will-hut/Prototypical/Script/Gamma_Color_Test/granger.png

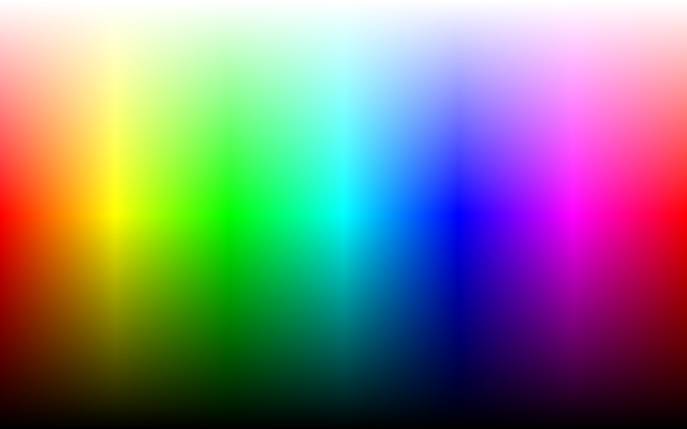
Script/Gamma_Color_Test/granger.png
