will-hut/Prototypical/Script/Img_to_Buffer/image.jpg

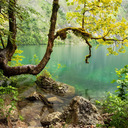
Script/Img_to_Buffer/image.jpg
