will-hut/Prototypical/Script/Img_to_Buffer/image3.jpg

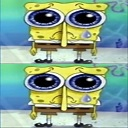
Script/Img_to_Buffer/image3.jpg
