will-hut/Prototypical/HW/HUB75-FPGA-Card/HUB75-FPGA-Card.xlsx

Item | Qty | Reference(s) | Name | Placed By | Digikey Link
1 | 32 | C1, C5, C6, C7, C8, C9, C12, C14, C15, C16, C17, C18, C20, C21, C22, C25, C26, C27, C30, C31, C32, C33, C34, C35, C36, C38, C41, C44, C45, C46, C53, C54 | 100n Cap 0603 | JLC
2 | 5 | C2, C13, C37, C39, C40 | 4.7u Cap 0603 | JLC
3 | 9 | C3, C28, C29, C42, C43, C48, C49, C52, C55 | 10u Cap 0603 | JLC
4 | 8 | C4, C10, C11, C23, C24, C47, C50, C51 | 1u Cap 0603 | JLC
5 | 1 | D1 | LED Red 0603 | JLC
6 | 5 | FB1, FB2, FB3, FB4, FB5 | FerriteBead 0603 | JLC
7 | 4 | H1, H2, H3, H4 | MountingHole | N/A
8 | 1 | J1 | JTAG 2x4 2.54mm | Me | Standard Pin headers
9 | 4 | J2, J4, J5, J7 | LedStrip 1x3 2.54mm | Me | Standard Pin headers
10 | 2 | J3, J6 | Hub75 IDC 16pin | Me | https://www.digikey.com/en/products/detail/cnc-tech/3020-16-0100-00/3441733
11 | 1 | J8 | Speaker 5.00mm 4 Screw Terminal | Me | https://www.digikey.com/en/products/detail/cui-devices/TB002-500-04BE/10064071
12 | 1 | J9 | USB_C_Receptacle_USB2.0 | Me | https://www.digikey.com/en/products/detail/gct/USB4105-GF-A/11198441
13 | 1 | J10 | USB_A_Stacked | Me | https://www.digikey.com/en/products/detail/cui-devices/UJ2-ADH-1-TH/6187916
14 | 2 | J11, J12 | Wirepad | N/A
15 | 4 | J13, J14, J15, J16 | Wirepad | N/A
16 | 16 | R1, R2, R3, R4, R5, R6, R7, R8, R9, R10, R11, R12, R13, R14, R15, R19 | 10k | JLC
17 | 1 | R16 | 12k | JLC
18 | 1 | R17 | 2.2k | JLC
19 | 1 | R18 | 470R | JLC
20 | 2 | R20, R21 | 5.1k | JLC
21 | 1 | U1 | T20Q100F3 | Me | https://www.digikey.com/en/products/detail/efinix-inc/T20Q100F3C3/19100262
22 | 1 | U2 | XC6206PxxxMR | JLC
23 | 1 | U3 | AP2112K-1.2 | Me | https://www.digikey.com/en/products/detail/diodes-incorporated/AP2112K-1-2TRG1/4570636
24 | 1 | U4 | 74AHCT245PW | Me | https://www.digikey.com/en/products/detail/nexperia-usa-inc/74AHCT245PW-118/1229680
25 | 1 | U5 | 74AHCT245PW | Me | https://www.digikey.com/en/products/detail/nexperia-usa-inc/74AHCT245PW-118/1229680
26 | 1 | U6 | 74AHCT245PW | Me | https://www.digikey.com/en/products/detail/nexperia-usa-inc/74AHCT245PW-118/1229680
27 | 1 | U7 | FT232H | Me | https://www.digikey.com/en/products/detail/ftdi-future-technology-devices-international-ltd/FT232HL-REEL/2614627
28 | 1 | U8 | 93LCxxBxxOT | Me | https://www.digikey.com/en/products/detail/microchip-technology/93LC56BT-I-OT/572825
29 | 1 | U9 | WMM7037AT2 | JLC
30 | 1 | U10 | HS-100B | JLC
31 | 1 | U11 | PAM8406 | JLC
32 | 1 | U12 | USBLC6-2SC6 | Me | https://www.digikey.com/en/products/detail/stmicroelectronics/USBLC6-2SC6/1040559
33 | 1 | U13 | CH334R | JLC
34 | 1 | X1 | ECS-2520MV-xxx-xx | Me | https://www.digikey.com/en/products/detail/ecs-inc/ECS-2520MV-250-CN-TR/8593608
35 | 1 | Y1 | Crystal_GND24 | JLC
