will-hut/Prototypical/HW/HUB75-FPGA-Card/3dmodels/AMM-3742-T-R--3DModel-STEP-461651.STEP

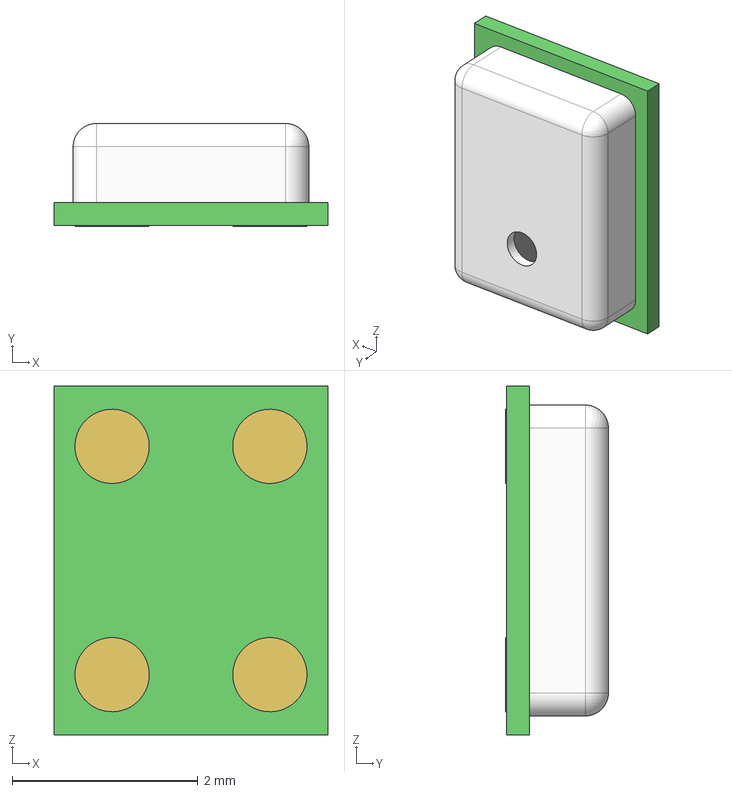
[picture p4: CAD file, 2024-02-10]
HW/HUB75-FPGA-Card/3dmodels/AMM-3742-T-R--3DModel-STEP-461651.STEP
2.95 x 1.11 x 3.76 mm
