will-hut/Prototypical/HW/HUB75-FPGA-Card/3dmodels/SS-52100-002--3DModel-STEP-510211.STEP

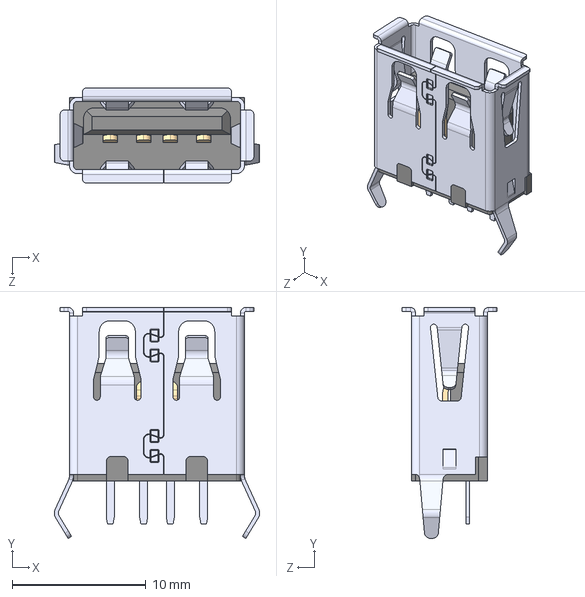
[picture p5: CAD file, 2024-02-10]
HW/HUB75-FPGA-Card/3dmodels/SS-52100-002--3DModel-STEP-510211.STEP
15.4 x 17.3 x 7.12 mm
