will-hut/Prototypical/HW/HUB75-FPGA-Card/3dmodels/TS-1187A-B-A-B.step

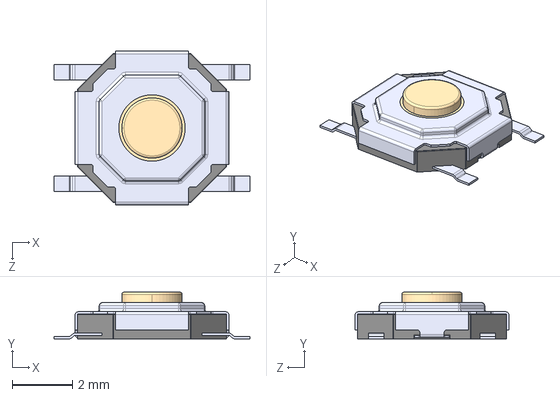
[picture p6: CAD file, 2024-02-10]
HW/HUB75-FPGA-Card/3dmodels/TS-1187A-B-A-B.step
6.50 x 1.55 x 5.10 mm
