will-hut/Prototypical/HW/HUB75-FPGA-Card/3dmodels/USB4145-03-0170-C_REVA2.step

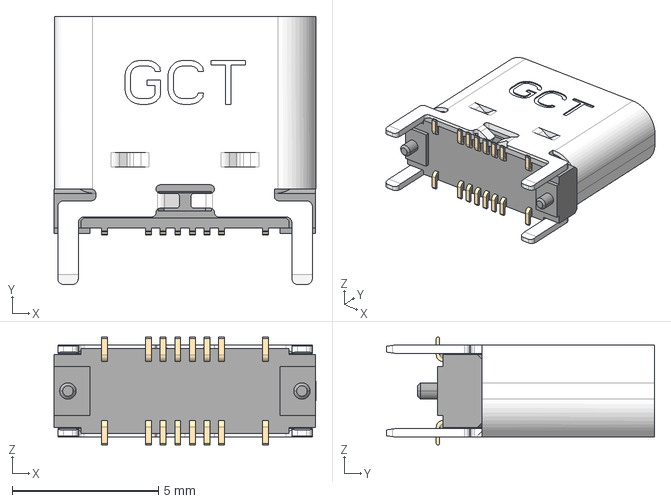
[picture p7: CAD file, 2024-02-08]
HW/HUB75-FPGA-Card/3dmodels/USB4145-03-0170-C_REVA2.step
8.95 x 9.16 x 3.69 mm
