will-hut/Prototypical/HW/Power-Module/Power-Module.kicad_pcb

## KiCad design HW/Power-Module/Power-Module.kicad_pcb (2024-02-26)

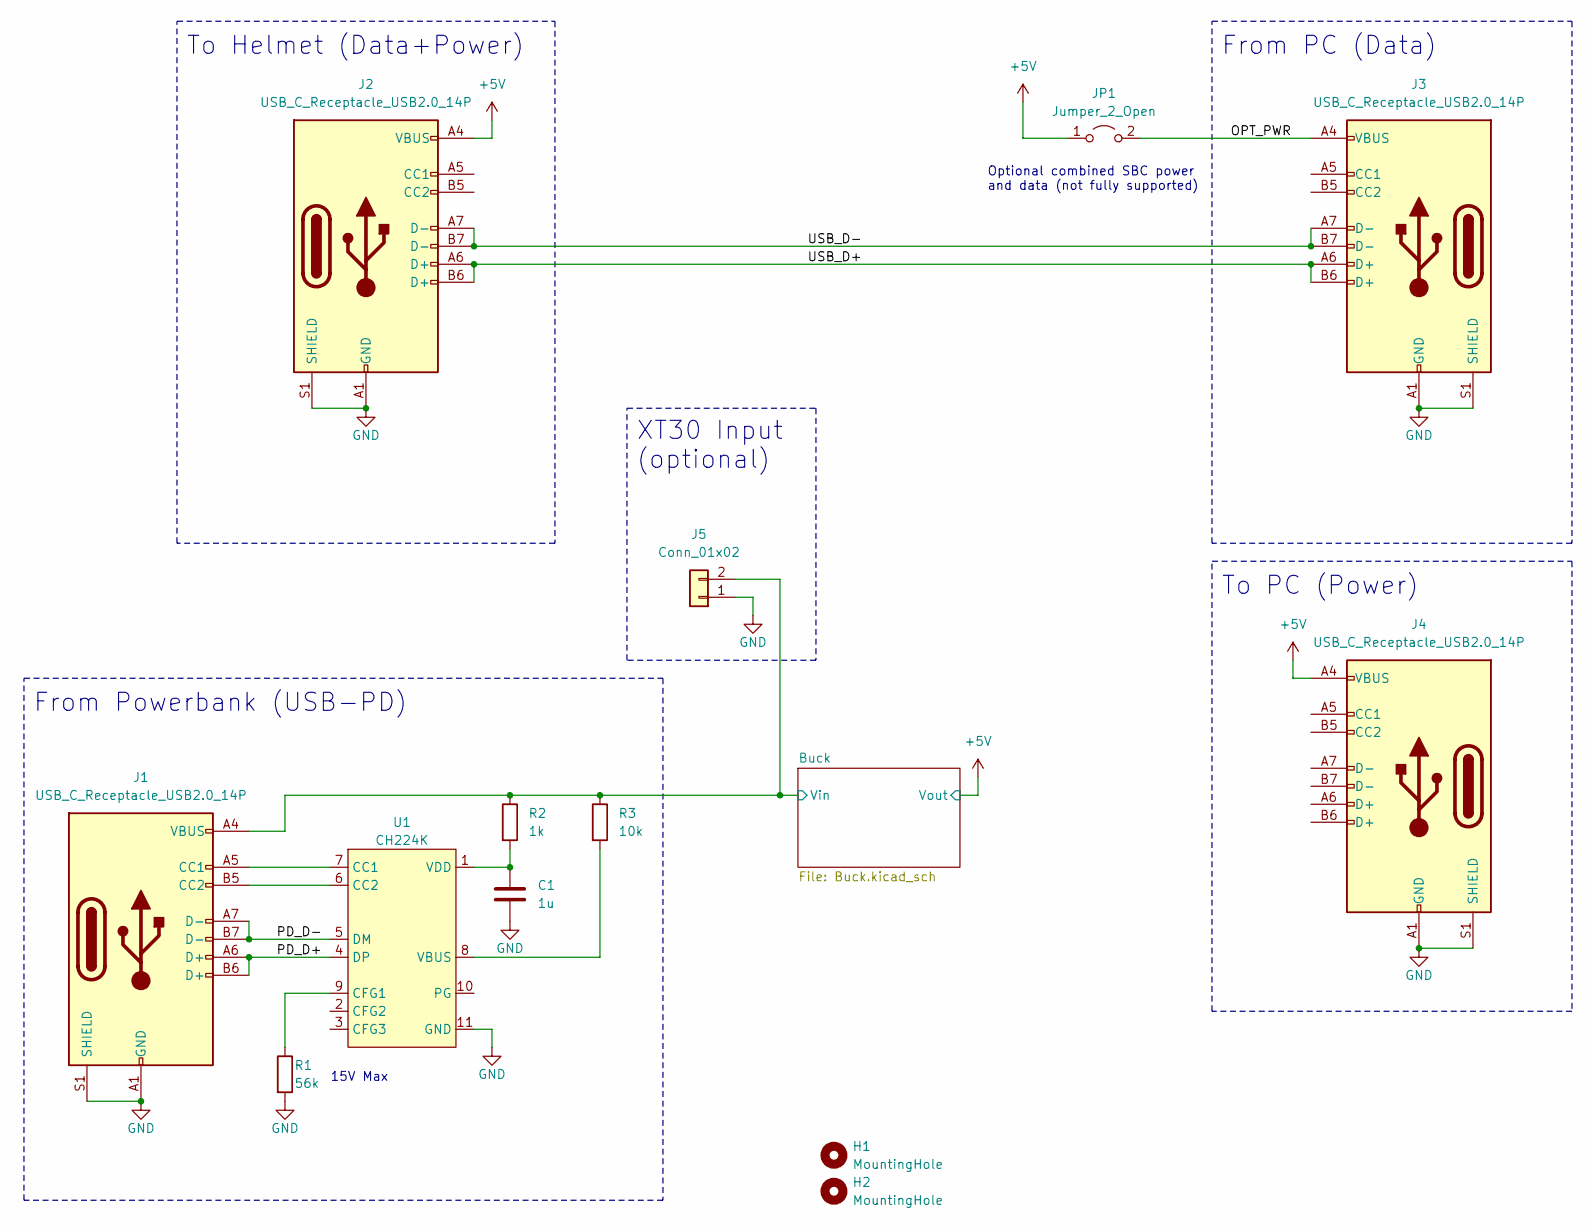
[picture p8: schematic Power-Module.kicad_sch]

Parts:
C1: 1u; C_0603_1608Metric; LCSC C15849
H1, H2: MountingHole; MountingHole_3.2mm_M3
J1, J2, J3, J4: USB_C_Receptacle_USB2.0_14P; USB_C_Receptacle_GCT_USB4105-xx-A_16P_TopMnt_Horizontal
J5: Conn_01x02; AMASS_XT30U-F_1x02_P5.0mm_Vertical
JP1: Jumper_2_Open; SolderJumper-2_P1.3mm_Open_Pad1.0x1.5mm
R1: 56k; R_0603_1608Metric; LCSC C23206
R2: 1k; R_0603_1608Metric; LCSC C21190
R3: 10k; R_0603_1608Metric; LCSC C25804
U1: CH224K; ESSOP-10_L4.9-W3.9-P1.0-LS6.0-TL-EP; LCSC Part C970725

Connections:
+5V: J2.A4 (VBUS), J2.A9 (VBUS), J2.B4 (VBUS), J2.B9 (VBUS), J4.A4 (VBUS), J4.A9 (VBUS), J4.B4 (VBUS), J4.B9 (VBUS), JP1.1 (A); also elsewhere on the board
/Buck/Vin: J1.A4 (VBUS), J1.A9 (VBUS), J1.B4 (VBUS), J1.B9 (VBUS), J5.2, R2.1, R3.1; also elsewhere on the board
/OPT_PWR: J3.A4 (VBUS), J3.A9 (VBUS), J3.B4 (VBUS), J3.B9 (VBUS), JP1.2 (B)
/PD_D+: J1.A6 (D+), J1.B6 (D+), U1.4 (DP)
/PD_D-: J1.A7 (D-), J1.B7 (D-), U1.5 (DM)
/USB_D+: J2.A6 (D+), J2.B6 (D+), J3.A6 (D+), J3.B6 (D+)
/USB_D-: J2.A7 (D-), J2.B7 (D-), J3.A7 (D-), J3.B7 (D-)
GND: C1.2, J1.A1 (GND), J1.A12 (GND), J1.B1 (GND), J1.B12 (GND), J1.S1 (SHIELD), J2.A1 (GND), J2.A12 (GND), J2.B1 (GND), J2.B12 (GND), J2.S1 (SHIELD), J3.A1 (GND), J3.A12 (GND), J3.B1 (GND), J3.B12 (GND), J3.S1 (SHIELD), J4.A1 (GND), J4.A12 (GND), J4.B1 (GND), J4.B12 (GND), J4.S1 (SHIELD), J5.1, R1.2, U1.11 (GND); also elsewhere on the board
unnamed: J1.A5 (CC1), U1.7 (CC1)
unnamed: J1.B5 (CC2), U1.6 (CC2)
unnamed: R1.1, U1.9 (CFG1)
unnamed: R3.2, U1.8 (VBUS)
unnamed: C1.1, R2.2, U1.1 (VDD)

Notes on the sheet:
To Helmet (Data+Power)
From PC (Data)
Optional combined SBC power and data (not fully supported)
15V Max
From Powerbank (USB-PD)
To PC (Power)
XT30 Input (optional)

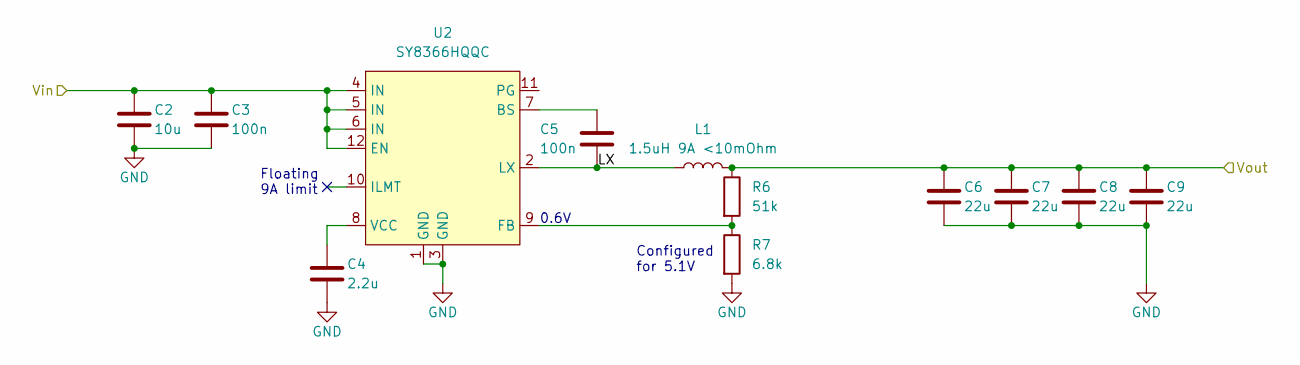
[picture p9: schematic Buck.kicad_sch]

Parts:
C2: 10u; C_0603_1608Metric
C3, C5: 100n; C_0603_1608Metric
C4: 2.2u; C_0603_1608Metric
C6, C7, C8, C9: 22u; C_0805_2012Metric
L1: 1.5uH 9A <10mOhm; IND-SMD_L7.0-W6.6
R6: 51k; R_0603_1608Metric
R7: 6.8k; R_0603_1608Metric
U2: SY8366HQQC; QFN-12_L3.0-W3.0-P0.45-TL-EP; LCSC Part C178253

Connections:
+5V: C6.1, C7.1, C8.1, C9.1, L1.2, R6.1; also elsewhere on the board
/Buck/LX: C5.2, L1.1, U2.2 (LX)
/Buck/Vin: C2.1, C3.1, U2.4 (IN), U2.5 (IN), U2.6 (IN), U2.12 (EN); also elsewhere on the board
GND: C2.2, C3.2, C4.2, C6.2, C7.2, C8.2, C9.2, R7.2, U2.1 (GND), U2.3 (GND); also elsewhere on the board
unnamed: C5.1, U2.7 (BS)
unnamed: R6.2, R7.1, U2.9 (FB)
unnamed: C4.1, U2.8 (VCC)

Notes on the sheet:
Floating 9A limit
0.6V
Configured for 5.1V

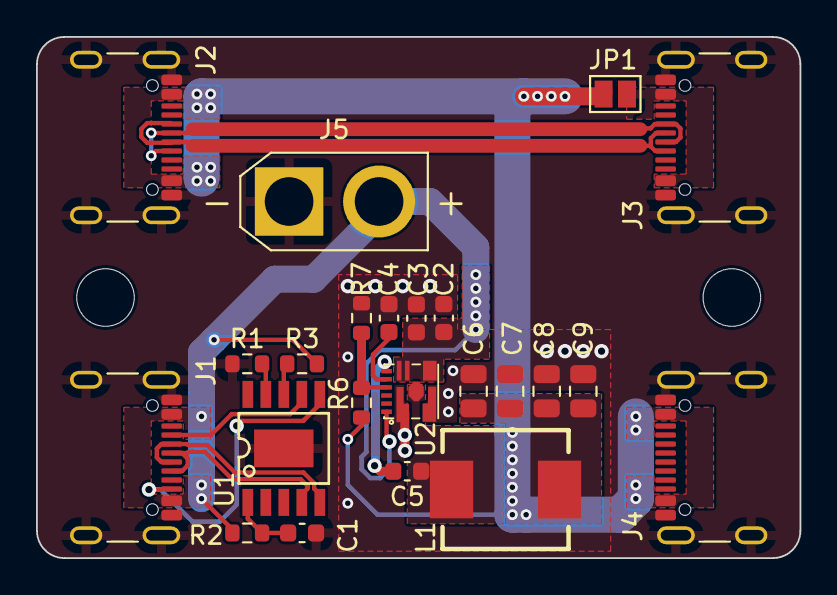
[picture p10: board Power-Module.kicad_pcb from above]

Board: 2 copper layers, 42.4 x 29.0 mm, 25 parts (0 on the bottom side), 17 nets.
