will-hut/Prototypical/HW/HUB75-FPGA-Card/HUB75-FPGA-Card.kicad_pcb

## KiCad design HW/HUB75-FPGA-Card/HUB75-FPGA-Card.kicad_pcb (2024-02-26)

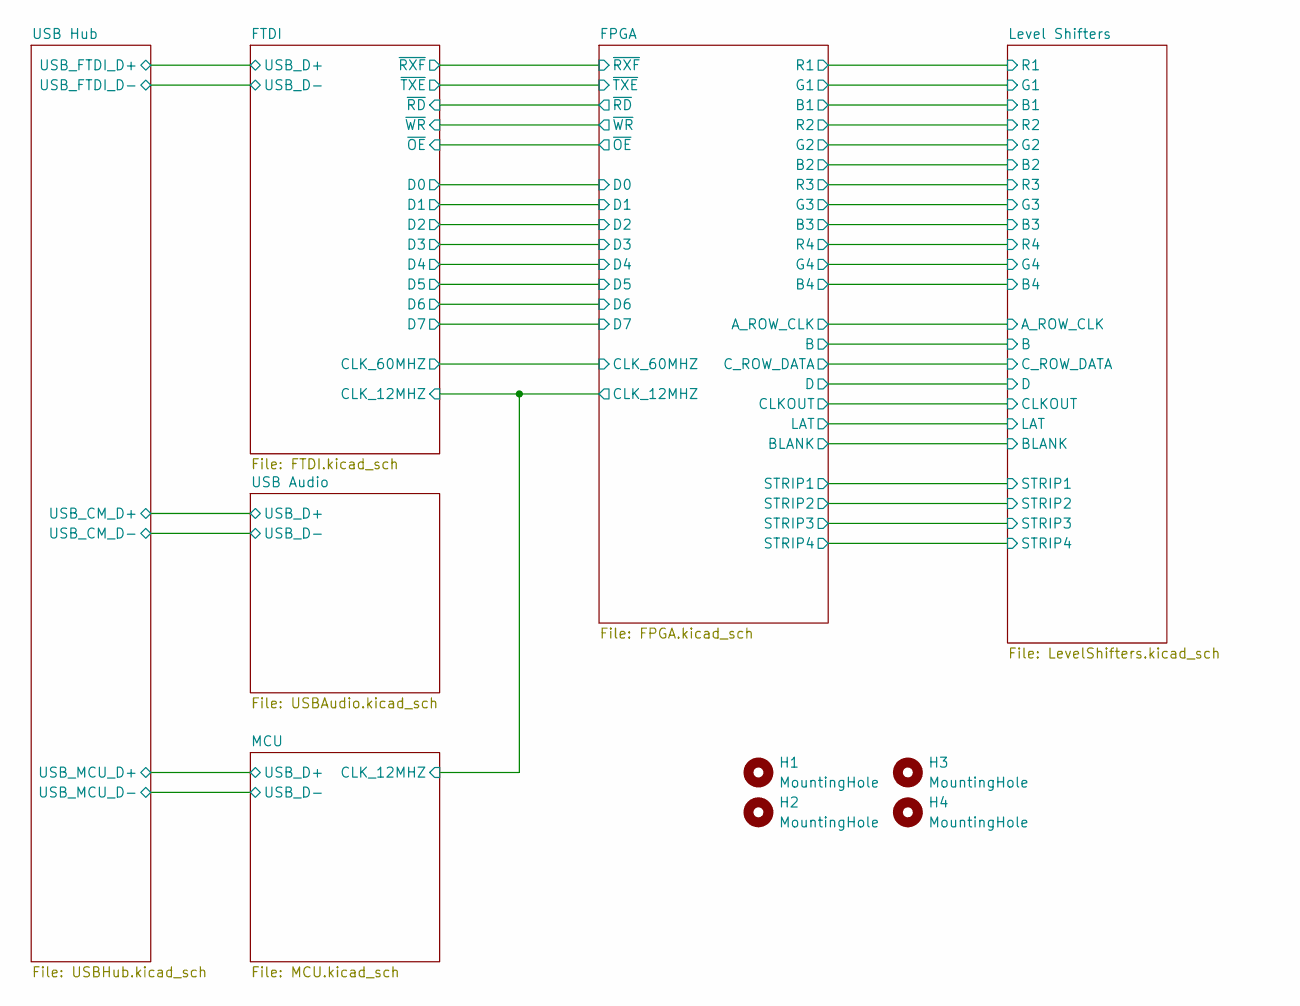
[picture p11: schematic HUB75-FPGA-Card.kicad_sch]

Parts:
H1, H2, H3, H4: MountingHole; MountingHole_3.2mm_M3

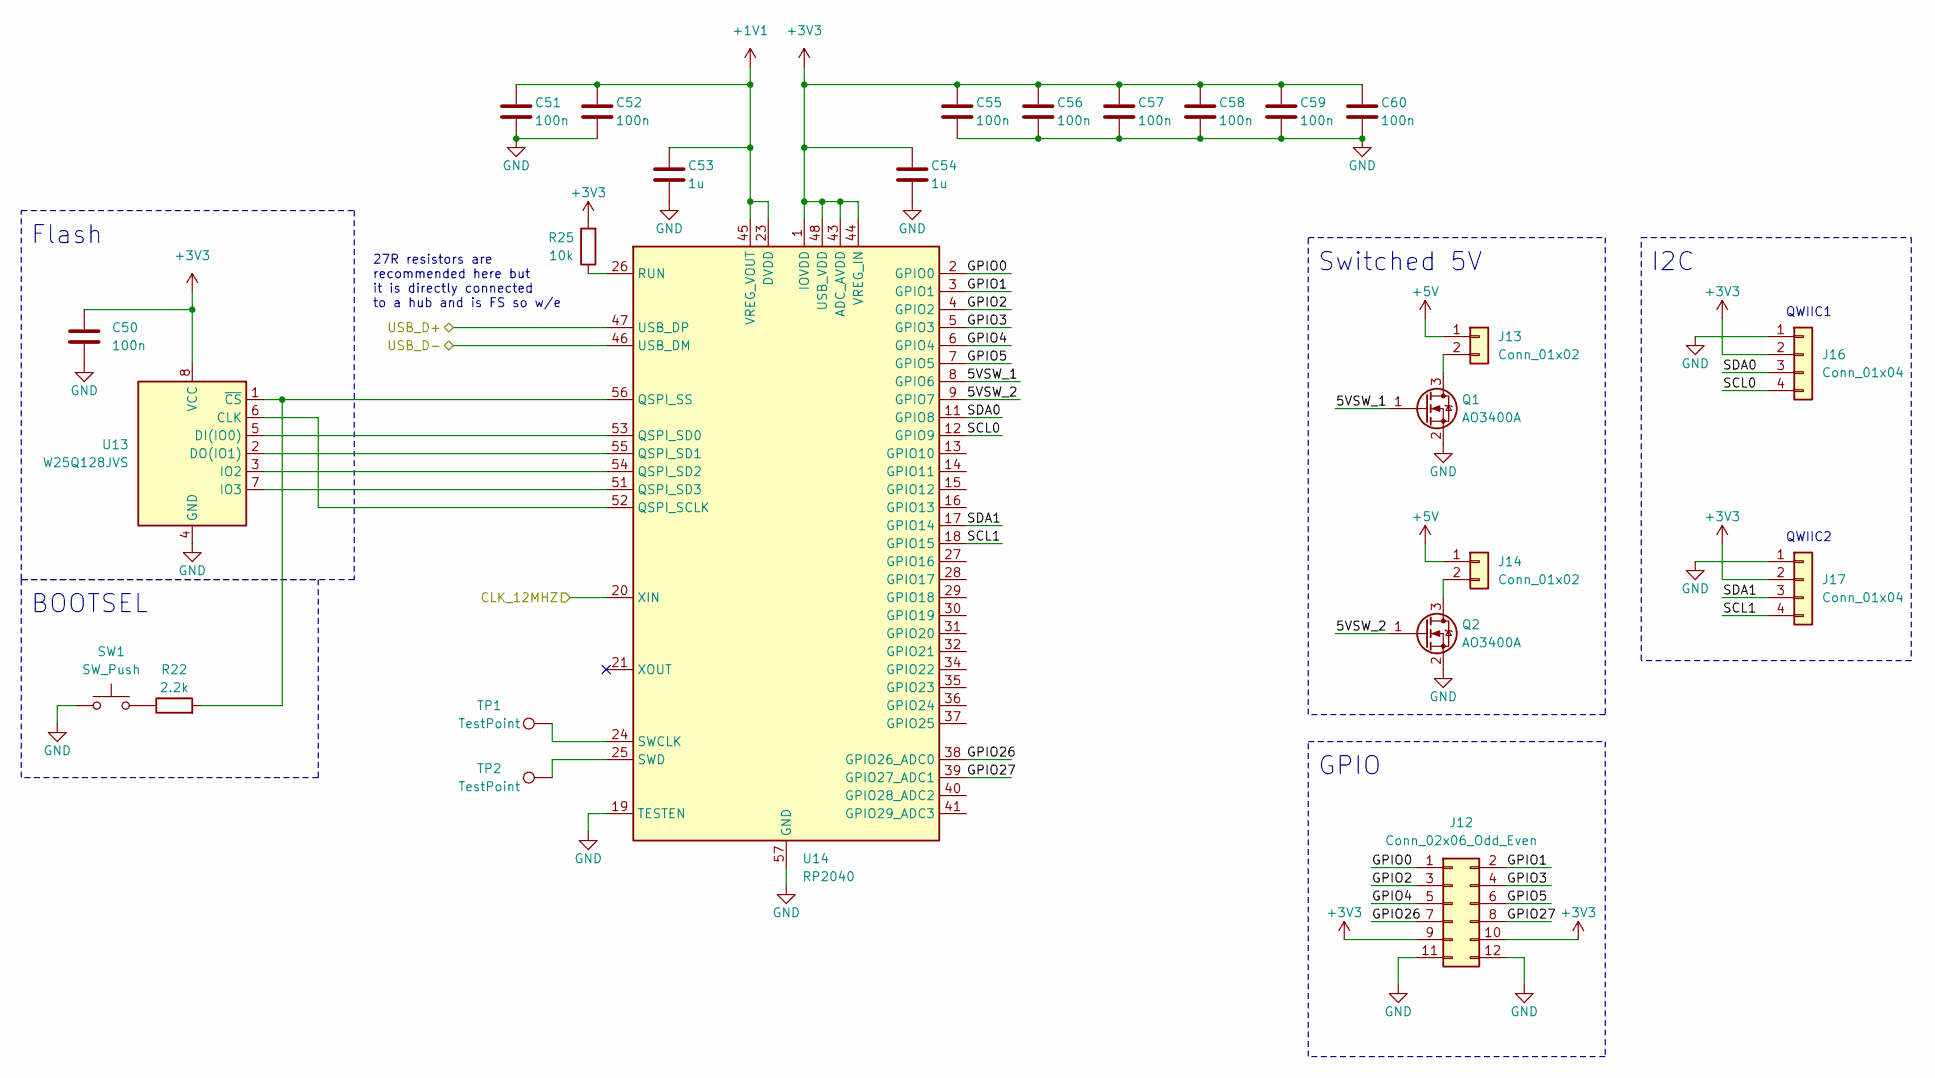
[picture p12: schematic MCU.kicad_sch]

Parts:
C50, C51, C52, C55, C56, C57, C58, C59, C60: 100n; C_0603_1608Metric
C53, C54: 1u; C_0603_1608Metric
J12: Conn_02x06_Odd_Even; PinHeader_2x06_P2.54mm_Vertical
J13, J14: Conn_01x02; PinHeader_1x02_P2.54mm_Vertical
J16, J17: Conn_01x04; JST_SH_BM04B-SRSS-TB_1x04-1MP_P1.00mm_Vertical
Q1, Q2: AO3400A; SOT-23
R22: 2.2k; R_0603_1608Metric
R25: 10k; R_0603_1608Metric
SW1: SW_Push; SW_TS-1187A-B-A-B
TP1, TP2: TestPoint; TestPoint_Pad_D1.0mm
U13: W25Q128JVS; SOIC-8_5.23x5.23mm_P1.27mm
U14: RP2040; QFN-56-1EP_7x7mm_P0.4mm_EP3.2x3.2mm

Connections:
+1V1: C51.1, C52.1, C53.1, U14.23 (DVDD), U14.45 (VREG_VOUT), U14.50 (DVDD)
+3V3: C50.1, C54.1, C55.1, C56.1, C57.1, C58.1, C59.1, C60.1, J12.9, J12.10, J16.2, J17.2, R25.2, U13.8 (VCC), U14.1 (IOVDD), U14.10 (IOVDD), U14.22 (IOVDD), U14.33 (IOVDD), U14.42 (IOVDD), U14.43 (ADC_AVDD), U14.44 (VREG_IN), U14.48 (USB_VDD), U14.49 (IOVDD); also elsewhere on the board
+5V: J13.1, J14.1; also elsewhere on the board
/FPGA/CLK_12MHZ: U14.20 (XIN); also elsewhere on the board
/MCU/5VSW_1: Q1.1 (G), U14.8 (GPIO6)
/MCU/5VSW_2: Q2.1 (G), U14.9 (GPIO7)
/MCU/GPIO0: J12.1, U14.2 (GPIO0)
/MCU/GPIO1: J12.2, U14.3 (GPIO1)
/MCU/GPIO2: J12.3, U14.4 (GPIO2)
/MCU/GPIO3: J12.4, U14.5 (GPIO3)
/MCU/GPIO4: J12.5, U14.6 (GPIO4)
/MCU/GPIO5: J12.6, U14.7 (GPIO5)
/MCU/GPIO26: J12.7, U14.38 (GPIO26_ADC0)
/MCU/GPIO27: J12.8, U14.39 (GPIO27_ADC1)
/MCU/SCL0: J16.4, U14.12 (GPIO9)
/MCU/SCL1: J17.4, U14.18 (GPIO15)
/MCU/SDA0: J16.3, U14.11 (GPIO8)
/MCU/SDA1: J17.3, U14.17 (GPIO14)
/MCU/USB_D+: U14.47 (USB_DP); also elsewhere on the board
/MCU/USB_D-: U14.46 (USB_DM); also elsewhere on the board
GND: C50.2, C51.2, C52.2, C53.2, C54.2, C55.2, C56.2, C57.2, C58.2, C59.2, C60.2, J12.11, J12.12, J16.1, J17.1, Q1.2 (S), Q2.2 (S), SW1.1, U13.4 (GND), U14.19 (TESTEN), U14.57 (GND); also elsewhere on the board
unnamed: J13.2, Q1.3 (D)
unnamed: J14.2, Q2.3 (D)
unnamed: R22.1, SW1.2
unnamed: U13.6 (CLK), U14.52 (QSPI_SCLK)
unnamed: U13.5 (DI(IO0)), U14.53 (QSPI_SD0)
unnamed: U13.2 (DO(IO1)), U14.55 (QSPI_SD1)
unnamed: U13.3 (IO2), U14.54 (QSPI_SD2)
unnamed: U13.7 (IO3), U14.51 (QSPI_SD3)
unnamed: R22.2, U13.1 (~CS), U14.56 (QSPI_SS)
unnamed: R25.1, U14.26 (RUN)
unnamed: TP1.1, U14.24 (SWCLK)
unnamed: TP2.1, U14.25 (SWD)

Notes on the sheet:
Flash
QWIIC2
27R resistors are recommended here but it is directly connected to a hub and is FS so w/e
I2C
GPIO
Switched 5V
QWIIC1
BOOTSEL

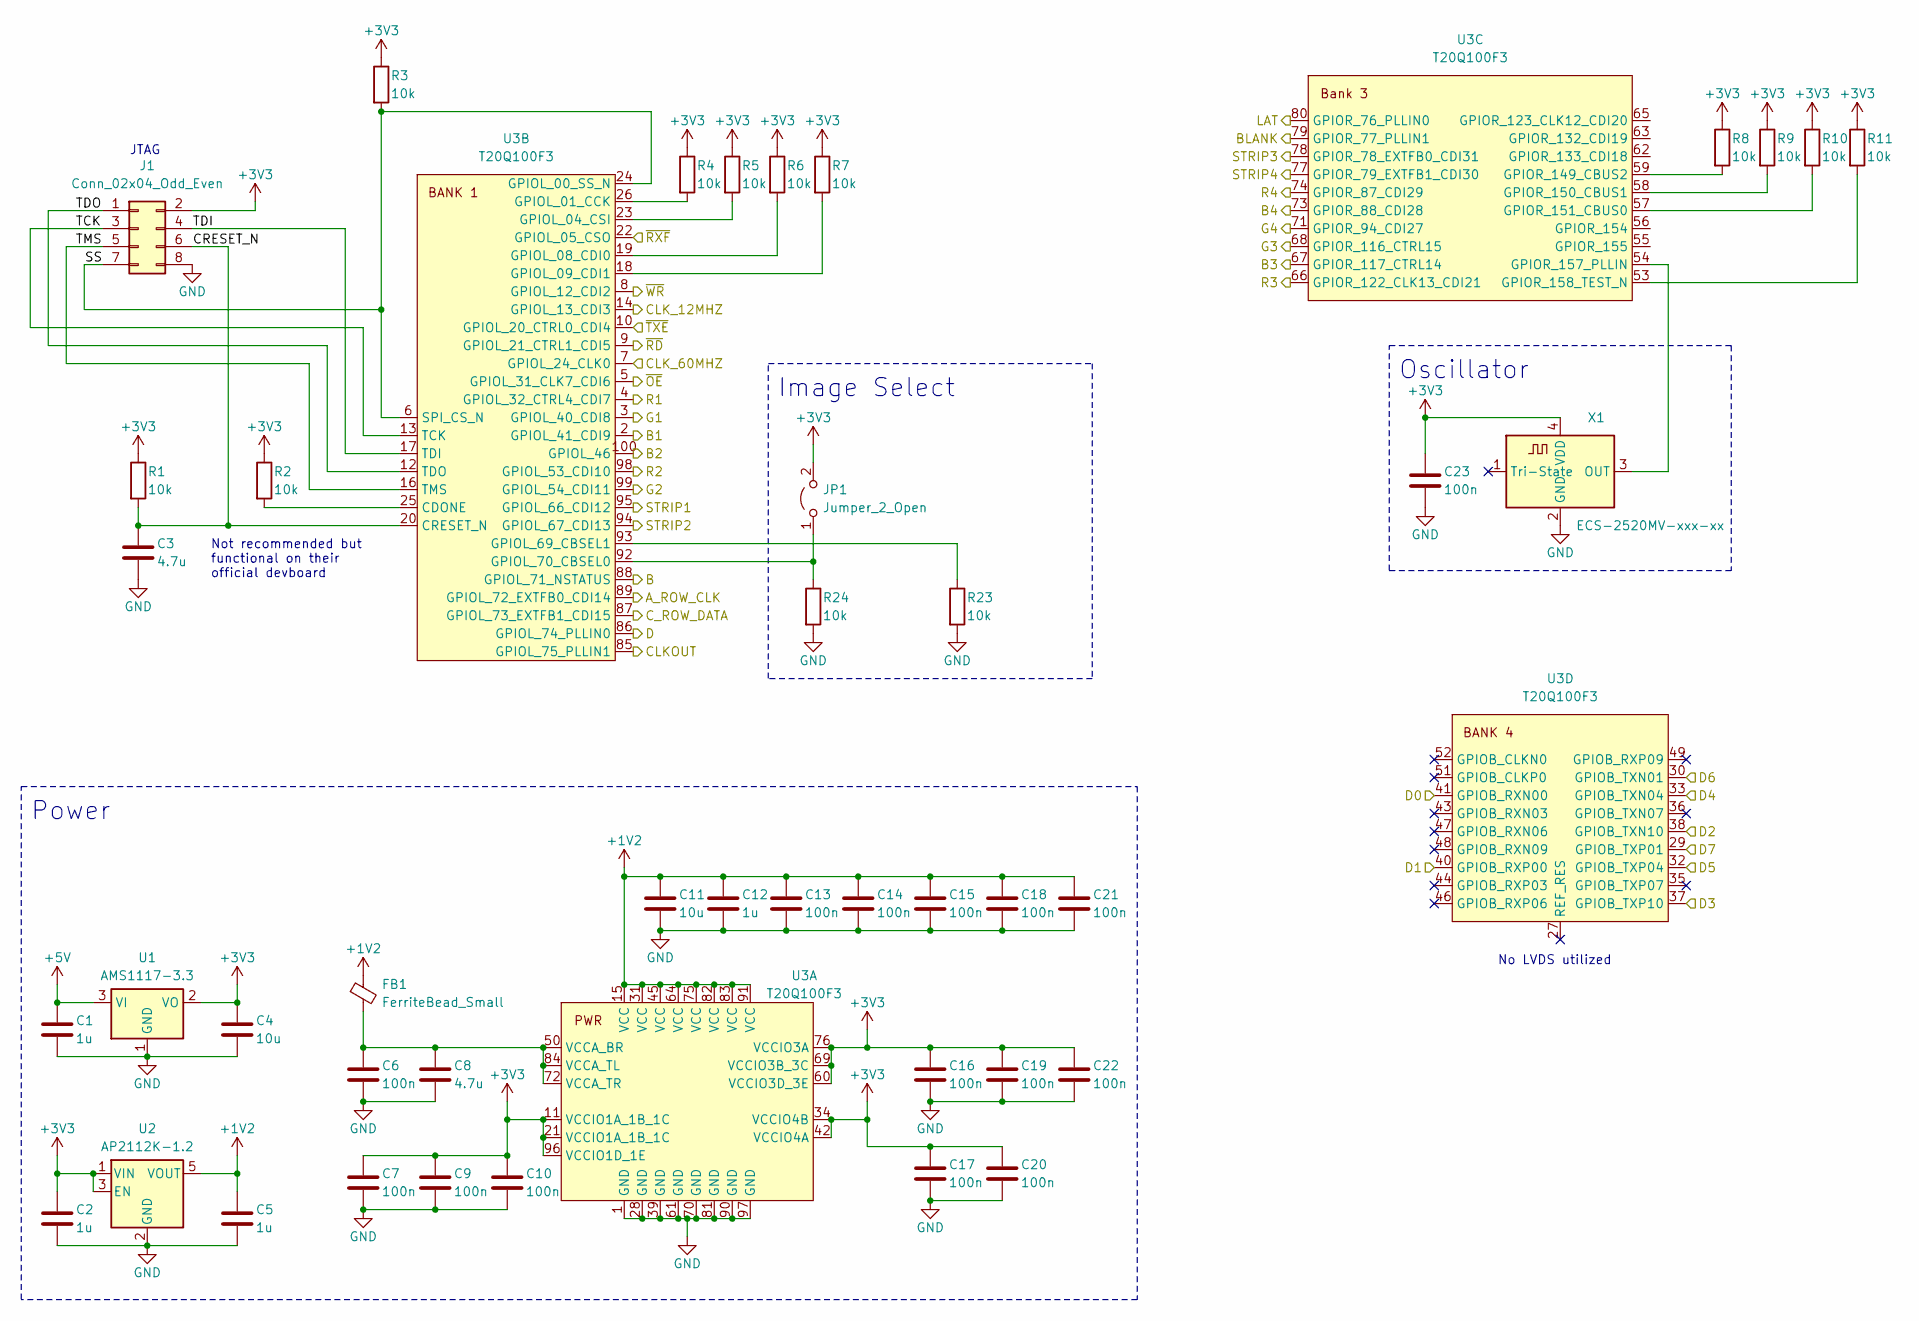
[picture p13: schematic FPGA.kicad_sch]

Parts:
C1, C2, C5, C12: 1u; C_0603_1608Metric
C3, C8: 4.7u; C_0603_1608Metric
C4, C11: 10u; C_0603_1608Metric
C6, C7, C9, C10, C13, C14, C15, C16, C17, C18, C19, C20, C21, C22, C23: 100n; C_0603_1608Metric
FB1: FerriteBead_Small; R_0603_1608Metric
J1: Conn_02x04_Odd_Even; PinHeader_2x04_P2.54mm_Vertical
JP1: Jumper_2_Open; PinHeader_1x02_P2.54mm_Vertical
R1, R2, R3, R4, R5, R6, R7, R8, R9, R10, R11, R23, R24: 10k; R_0603_1608Metric
U1: AMS1117-3.3; SOT-223-3_TabPin2
U2: AP2112K-1.2; SOT-23-5
U3: T20Q100F3; TQFP-100_14x14mm_P0.5mm
X1: ECS-2520MV-xxx-xx; Oscillator_SMD_ECS_2520MV-xxx-xx-4Pin_2.5x2.0mm

Connections:
+1V2: C5.1, C11.1, C12.1, C13.1, C14.1, C15.1, C18.1, C21.1, FB1.1, U2.5 (VOUT), U3.15 (VCC), U3.31 (VCC), U3.45 (VCC), U3.64 (VCC), U3.75 (VCC), U3.82 (VCC), U3.83 (VCC), U3.91 (VCC)
+3V3: C2.1, C4.1, C7.1, C9.1, C10.1, C16.1, C17.1, C19.1, C20.1, C22.1, C23.1, J1.2, JP1.2 (B), R1.1, R2.1, R3.1, R4.1, R5.1, R6.1, R7.1, R8.1, R9.1, R10.1, R11.1, U1.2 (VO), U2.1 (VIN), U2.3 (EN), U3.11 (VCCIO1A_1B_1C), U3.21 (VCCIO1A_1B_1C), U3.34 (VCCIO4B), U3.42 (VCCIO4A), U3.60 (VCCIO3D_3E), U3.69 (VCCIO3B_3C), U3.76 (VCCIO3A), U3.96 (VCCIO1D_1E), X1.4 (VDD); also elsewhere on the board
+5V: C1.1, U1.3 (VI); also elsewhere on the board
/FPGA/A_ROW_CLK: U3.89 (GPIOL_72_EXTFB0_CDI14); also elsewhere on the board
/FPGA/B: U3.88 (GPIOL_71_NSTATUS); also elsewhere on the board
/FPGA/B1: U3.2 (GPIOL_41_CDI9); also elsewhere on the board
/FPGA/B2: U3.100 (GPIOL_46); also elsewhere on the board
/FPGA/B3: U3.67 (GPIOR_117_CTRL14); also elsewhere on the board
/FPGA/B4: U3.73 (GPIOR_88_CDI28); also elsewhere on the board
/FPGA/BLANK: U3.79 (GPIOR_77_PLLIN1); also elsewhere on the board
/FPGA/CLKOUT: U3.85 (GPIOL_75_PLLIN1); also elsewhere on the board
/FPGA/CLK_12MHZ: U3.14 (GPIOL_13_CDI3); also elsewhere on the board
/FPGA/CLK_60MHZ: U3.7 (GPIOL_24_CLK0); also elsewhere on the board
/FPGA/CRESET_N: C3.1, J1.6, R1.2, U3.20 (CRESET_N)
/FPGA/C_ROW_DATA: U3.87 (GPIOL_73_EXTFB1_CDI15); also elsewhere on the board
/FPGA/D: U3.86 (GPIOL_74_PLLIN0); also elsewhere on the board
/FPGA/D0: U3.41 (GPIOB_RXN00); also elsewhere on the board
/FPGA/D1: U3.40 (GPIOB_RXP00); also elsewhere on the board
/FPGA/D2: U3.38 (GPIOB_TXN10); also elsewhere on the board
/FPGA/D3: U3.37 (GPIOB_TXP10); also elsewhere on the board
/FPGA/D4: U3.33 (GPIOB_TXN04); also elsewhere on the board
/FPGA/D5: U3.32 (GPIOB_TXP04); also elsewhere on the board
/FPGA/D6: U3.30 (GPIOB_TXN01); also elsewhere on the board
/FPGA/D7: U3.29 (GPIOB_TXP01); also elsewhere on the board
/FPGA/G1: U3.3 (GPIOL_40_CDI8); also elsewhere on the board
/FPGA/G2: U3.99 (GPIOL_54_CDI11); also elsewhere on the board
/FPGA/G3: U3.68 (GPIOR_116_CTRL15); also elsewhere on the board
/FPGA/G4: U3.71 (GPIOR_94_CDI27); also elsewhere on the board
/FPGA/LAT: U3.80 (GPIOR_76_PLLIN0); also elsewhere on the board
/FPGA/R1: U3.4 (GPIOL_32_CTRL4_CDI7); also elsewhere on the board
/FPGA/R2: U3.98 (GPIOL_53_CDI10); also elsewhere on the board
/FPGA/R3: U3.66 (GPIOR_122_CLK13_CDI21); also elsewhere on the board
/FPGA/R4: U3.74 (GPIOR_87_CDI29); also elsewhere on the board
/FPGA/SS: J1.7, R3.2, U3.6 (SPI_CS_N), U3.24 (GPIOL_00_SS_N)
/FPGA/STRIP1: U3.95 (GPIOL_66_CDI12); also elsewhere on the board
/FPGA/STRIP2: U3.94 (GPIOL_67_CDI13); also elsewhere on the board
/FPGA/STRIP3: U3.78 (GPIOR_78_EXTFB0_CDI31); also elsewhere on the board
/FPGA/STRIP4: U3.77 (GPIOR_79_EXTFB1_CDI30); also elsewhere on the board
/FPGA/TCK: J1.3, U3.13 (TCK)
/FPGA/TDI: J1.4, U3.17 (TDI)
/FPGA/TDO: J1.1, U3.12 (TDO)
/FPGA/TMS: J1.5, U3.16 (TMS)
/FPGA/~OE: U3.5 (GPIOL_31_CLK7_CDI6); also elsewhere on the board
/FPGA/~RD: U3.9 (GPIOL_21_CTRL1_CDI5); also elsewhere on the board
/FPGA/~RXF: U3.22 (GPIOL_05_CSO); also elsewhere on the board
/FPGA/~TXE: U3.10 (GPIOL_20_CTRL0_CDI4); also elsewhere on the board
/FPGA/~WR: U3.8 (GPIOL_12_CDI2); also elsewhere on the board
GND: C1.2, C2.2, C3.2, C4.2, C5.2, C6.2, C7.2, C8.2, C9.2, C10.2, C11.2, C12.2, C13.2, C14.2, C15.2, C16.2, C17.2, C18.2, C19.2, C20.2, C21.2, C22.2, C23.2, J1.8, R23.2, R24.2, U1.1 (GND), U2.2 (GND), U3.1 (GND), U3.28 (GND), U3.39 (GND), U3.61 (GND), U3.70 (GND), U3.81 (GND), U3.90 (GND), U3.97 (GND), X1.2 (GND); also elsewhere on the board
unnamed: JP1.1 (A), R24.1, U3.92 (GPIOL_70_CBSEL0)
unnamed: C6.1, C8.1, FB1.2, U3.50 (VCCA_BR), U3.72 (VCCA_TR), U3.84 (VCCA_TL)
unnamed: R2.2, U3.25 (CDONE)
unnamed: R4.2, U3.26 (GPIOL_01_CCK)
unnamed: R5.2, U3.23 (GPIOL_04_CSI)
unnamed: R6.2, U3.19 (GPIOL_08_CDI0)
unnamed: R7.2, U3.18 (GPIOL_09_CDI1)
unnamed: R23.1, U3.93 (GPIOL_69_CBSEL1)
unnamed: R8.2, U3.59 (GPIOR_149_CBUS2)
unnamed: R9.2, U3.58 (GPIOR_150_CBUS1)
unnamed: R10.2, U3.57 (GPIOR_151_CBUS0)
unnamed: U3.54 (GPIOR_157_PLLIN), X1.3 (OUT)
unnamed: R11.2, U3.53 (GPIOR_158_TEST_N)

Notes on the sheet:
Image Select
JTAG
Power
No LVDS utilized
Not recommended but functional on their official devboard
Oscillator

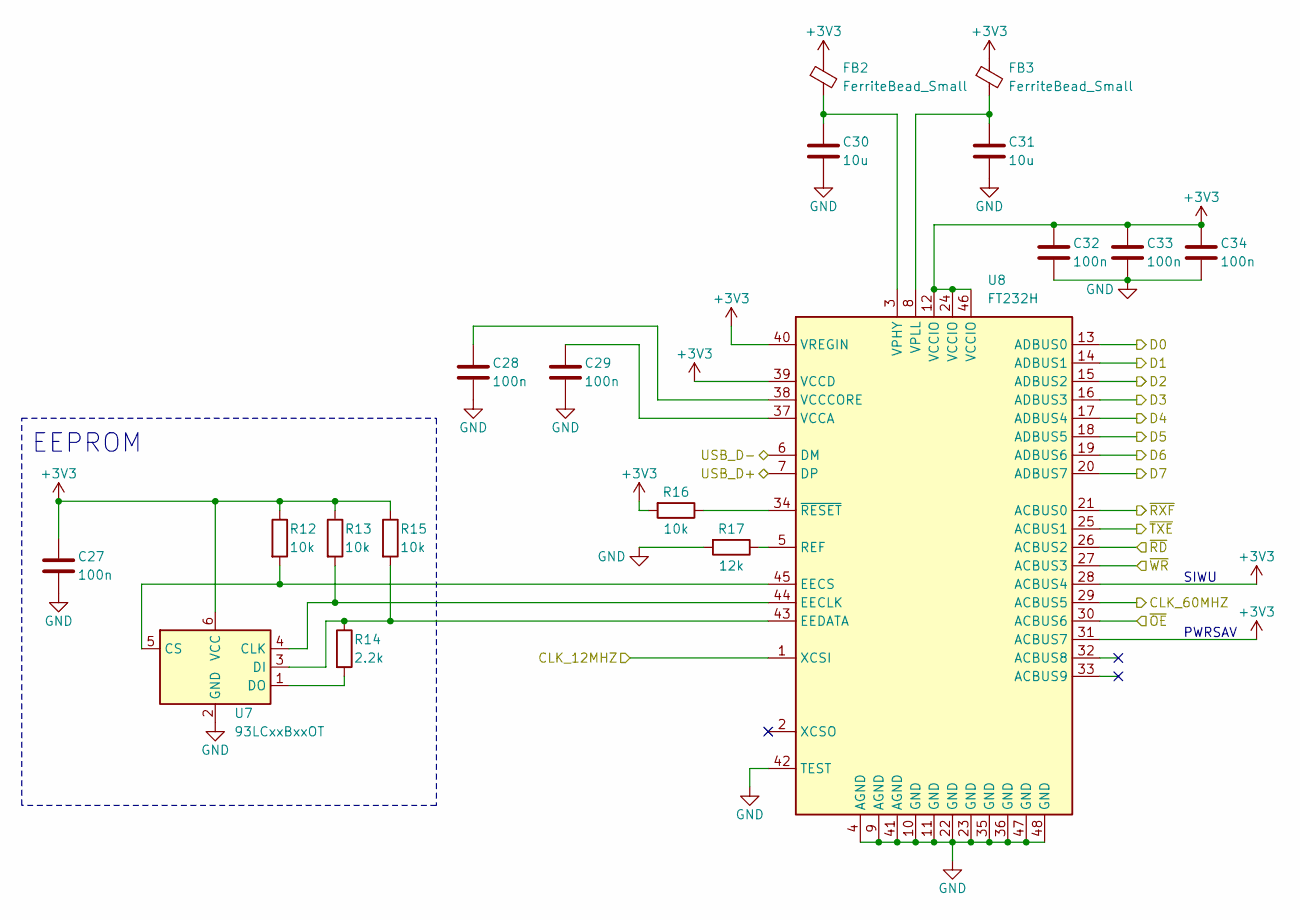
[picture p14: schematic FTDI.kicad_sch]

Parts:
C27, C28, C29, C32, C33, C34: 100n; C_0603_1608Metric
C30, C31: 10u; C_0603_1608Metric
FB2, FB3: FerriteBead_Small; R_0603_1608Metric
R12, R13, R15, R16: 10k; R_0603_1608Metric
R14: 2.2k; R_0603_1608Metric
R17: 12k; R_0603_1608Metric
U7: 93LCxxBxxOT; SOT-23-6
U8: FT232H; LQFP-48_7x7mm_P0.5mm

Connections:
+3V3: C27.1, C32.1, C33.1, C34.1, FB2.1, FB3.1, R12.1, R13.1, R15.1, R16.2, U7.6 (VCC), U8.12 (VCCIO), U8.24 (VCCIO), U8.28 (ACBUS4), U8.31 (ACBUS7), U8.39 (VCCD), U8.40 (VREGIN), U8.46 (VCCIO); also elsewhere on the board
/FPGA/CLK_12MHZ: U8.1 (XCSI); also elsewhere on the board
/FPGA/CLK_60MHZ: U8.29 (ACBUS5); also elsewhere on the board
/FPGA/D0: U8.13 (ADBUS0); also elsewhere on the board
/FPGA/D1: U8.14 (ADBUS1); also elsewhere on the board
/FPGA/D2: U8.15 (ADBUS2); also elsewhere on the board
/FPGA/D3: U8.16 (ADBUS3); also elsewhere on the board
/FPGA/D4: U8.17 (ADBUS4); also elsewhere on the board
/FPGA/D5: U8.18 (ADBUS5); also elsewhere on the board
/FPGA/D6: U8.19 (ADBUS6); also elsewhere on the board
/FPGA/D7: U8.20 (ADBUS7); also elsewhere on the board
/FPGA/~OE: U8.30 (ACBUS6); also elsewhere on the board
/FPGA/~RD: U8.26 (ACBUS2); also elsewhere on the board
/FPGA/~RXF: U8.21 (ACBUS0); also elsewhere on the board
/FPGA/~TXE: U8.25 (ACBUS1); also elsewhere on the board
/FPGA/~WR: U8.27 (ACBUS3); also elsewhere on the board
/FTDI/USB_D+: U8.7 (DP); also elsewhere on the board
/FTDI/USB_D-: U8.6 (DM); also elsewhere on the board
GND: C27.2, C28.2, C29.2, C30.2, C31.2, C32.2, C33.2, C34.2, R17.2, U7.2 (GND), U8.4 (AGND), U8.9 (AGND), U8.10 (GND), U8.11 (GND), U8.22 (GND), U8.23 (GND), U8.35 (GND), U8.36 (GND), U8.41 (AGND), U8.42 (TEST), U8.47 (GND), U8.48 (GND); also elsewhere on the board
unnamed: R13.2, U7.4 (CLK), U8.44 (EECLK)
unnamed: R12.2, U7.5 (CS), U8.45 (EECS)
unnamed: R14.1, R15.2, U7.3 (DI), U8.43 (EEDATA)
unnamed: R14.2, U7.1 (DO)
unnamed: R17.1, U8.5 (REF)
unnamed: C29.1, U8.37 (VCCA)
unnamed: C28.1, U8.38 (VCCCORE)
unnamed: C30.1, FB2.2, U8.3 (VPHY)
unnamed: C31.1, FB3.2, U8.8 (VPLL)
unnamed: R16.1, U8.34 (~RESET)

Notes on the sheet:
SIWU
EEPROM
PWRSAV

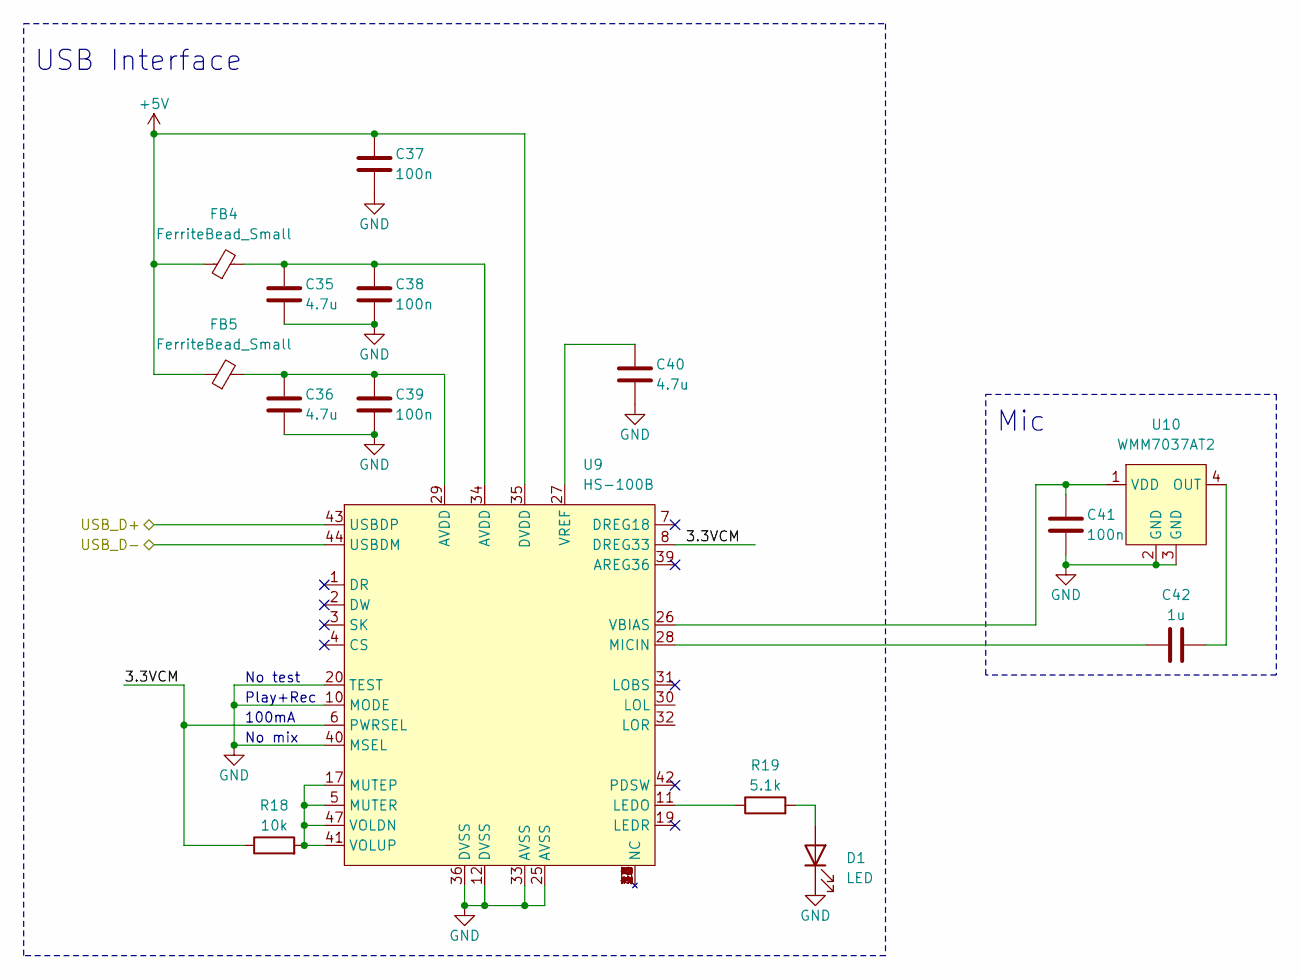
[picture p15: schematic USBAudio.kicad_sch]

Parts:
C35, C36, C40: 4.7u; C_0603_1608Metric
C37, C38, C39, C41: 100n; C_0603_1608Metric
C42: 1u; C_0603_1608Metric
D1: LED; D_0603_1608Metric
FB4, FB5: FerriteBead_Small; R_0603_1608Metric
R18: 10k; R_0603_1608Metric
R19: 5.1k; R_0603_1608Metric
U9: HS-100B; LQFP-48_7x7mm_P0.5mm
U10: WMM7037AT2

Connections:
+5V: C37.1, FB4.1, FB5.1, U9.35 (DVDD); also elsewhere on the board
/USB Audio/3.3VCM: R18.1, U9.6 (PWRSEL), U9.8 (DREG33)
/USB Audio/USB_D+: U9.43 (USBDP); also elsewhere on the board
/USB Audio/USB_D-: U9.44 (USBDM); also elsewhere on the board
GND: C35.2, C36.2, C37.2, C38.2, C39.2, C40.2, C41.2, D1.1 (K), U9.10 (MODE), U9.12 (DVSS), U9.20 (TEST), U9.25 (AVSS), U9.33 (AVSS), U9.36 (DVSS), U9.40 (MSEL), U10.2 (GND), U10.3 (GND); also elsewhere on the board
unnamed: C35.1, C38.1, FB4.2, U9.34 (AVDD)
unnamed: C36.1, C39.1, FB5.2, U9.29 (AVDD)
unnamed: D1.2 (A), R19.2
unnamed: R19.1, U9.11 (LEDO)
unnamed: C42.1, U9.28 (MICIN)
unnamed: R18.2, U9.5 (MUTER), U9.17 (MUTEP), U9.41 (VOLUP), U9.47 (VOLDN)
unnamed: C40.1, U9.27 (VREF)
unnamed: C42.2, U10.4 (OUT)
unnamed: C41.1, U9.26 (VBIAS), U10.1 (VDD)

Notes on the sheet:
No test
100mA
USB Interface
Mic
No mix
Play+Rec
