will-hut/Prototypical/HW/HUB75-FPGA-Card/HUB75-FPGA-Card.kicad_pcb

## KiCad design HW/HUB75-FPGA-Card/HUB75-FPGA-Card.kicad_pcb (continued)

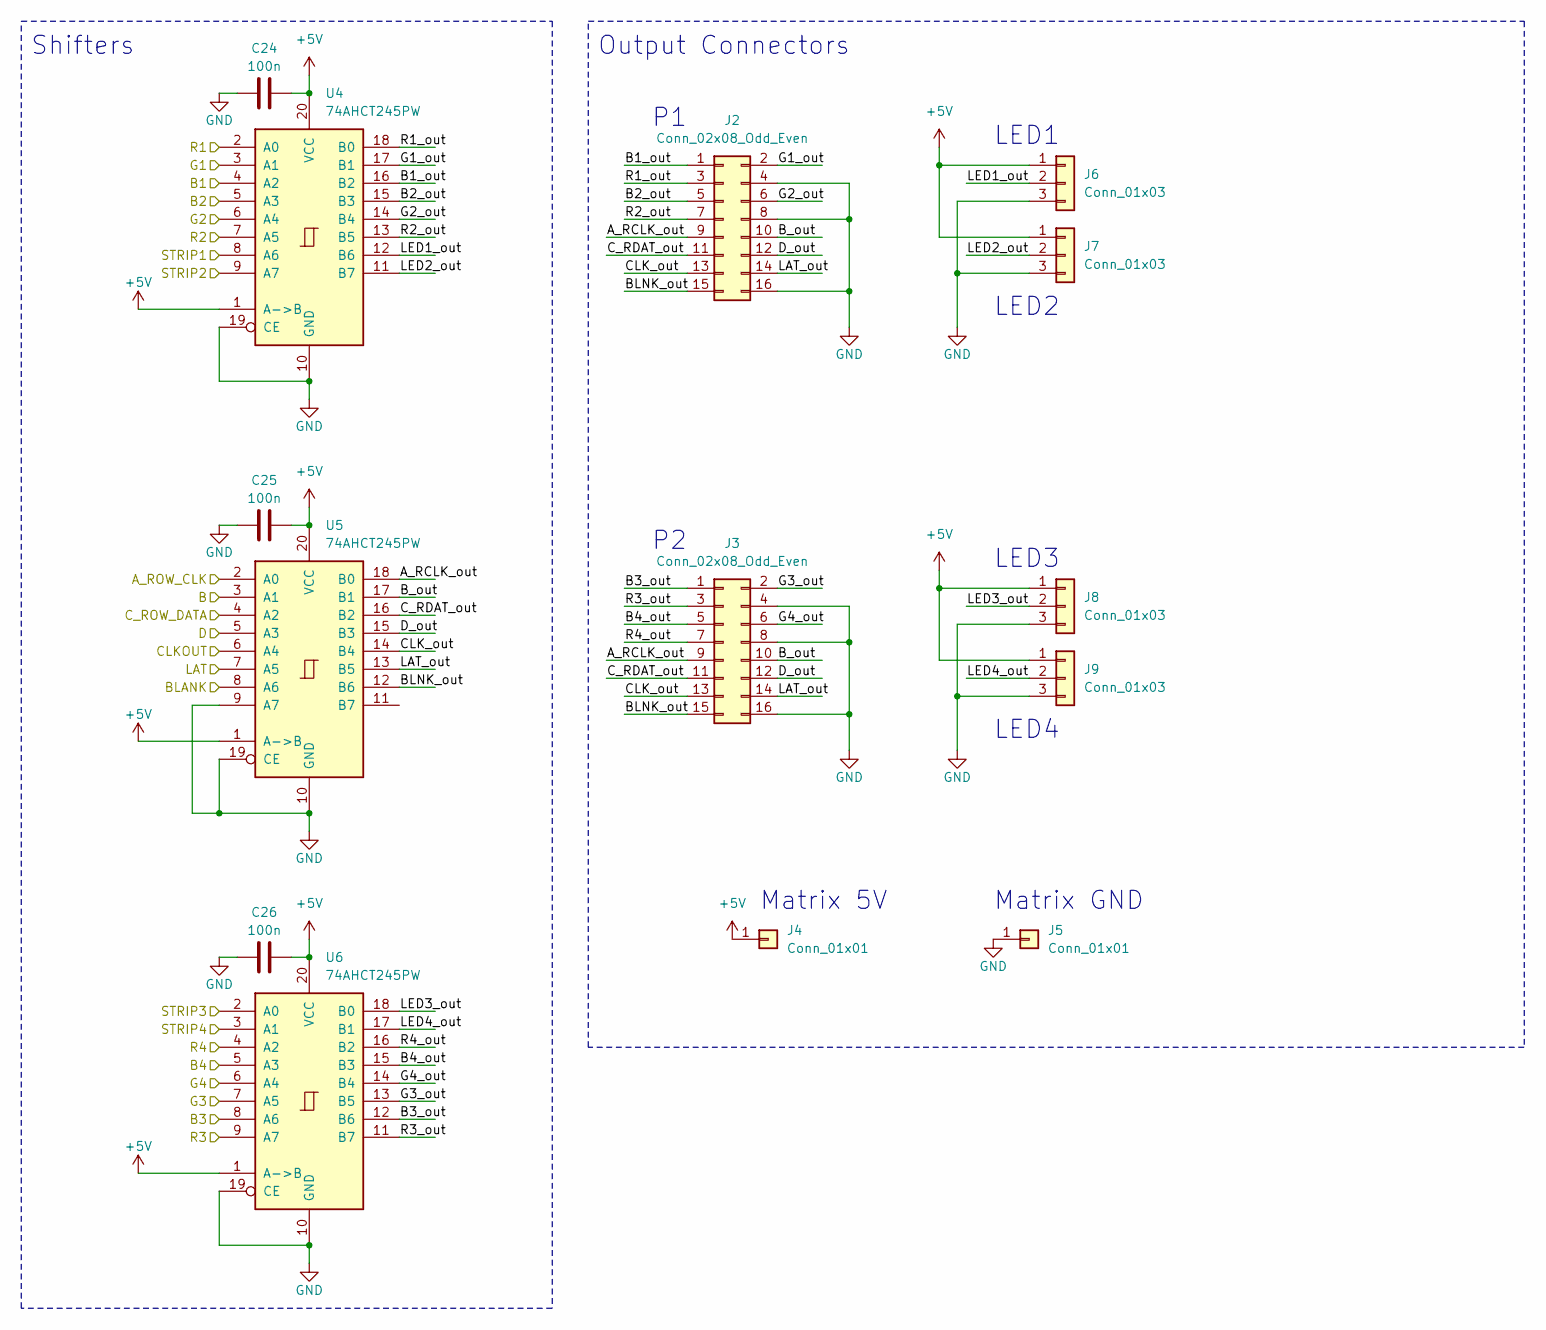
[picture p16: schematic LevelShifters.kicad_sch]

Parts:
C24, C25, C26: 100n; C_0603_1608Metric
J2, J3: Conn_02x08_Odd_Even; IDC-Header_2x08_P2.54mm_Vertical
J4, J5: Conn_01x01; SolderWire-2sqmm_1x01_D2mm_OD3.9mm
J6, J7, J8, J9: Conn_01x03; PinHeader_1x03_P2.54mm_Vertical
U4, U5, U6: 74AHCT245PW; TSSOP-20_4.4x6.5mm_P0.65mm

Connections:
+5V: C24.2, C25.2, C26.2, J4.1, J6.1, J7.1, J8.1, J9.1, U4.1 (A->B), U4.20 (VCC), U5.1 (A->B), U5.20 (VCC), U6.1 (A->B), U6.20 (VCC); also elsewhere on the board
/FPGA/A_ROW_CLK: U5.2 (A0); also elsewhere on the board
/FPGA/B: U5.3 (A1); also elsewhere on the board
/FPGA/B1: U4.4 (A2); also elsewhere on the board
/FPGA/B2: U4.5 (A3); also elsewhere on the board
/FPGA/B3: U6.8 (A6); also elsewhere on the board
/FPGA/B4: U6.5 (A3); also elsewhere on the board
/FPGA/BLANK: U5.8 (A6); also elsewhere on the board
/FPGA/CLKOUT: U5.6 (A4); also elsewhere on the board
/FPGA/C_ROW_DATA: U5.4 (A2); also elsewhere on the board
/FPGA/D: U5.5 (A3); also elsewhere on the board
/FPGA/G1: U4.3 (A1); also elsewhere on the board
/FPGA/G2: U4.6 (A4); also elsewhere on the board
/FPGA/G3: U6.7 (A5); also elsewhere on the board
/FPGA/G4: U6.6 (A4); also elsewhere on the board
/FPGA/LAT: U5.7 (A5); also elsewhere on the board
/FPGA/R1: U4.2 (A0); also elsewhere on the board
/FPGA/R2: U4.7 (A5); also elsewhere on the board
/FPGA/R3: U6.9 (A7); also elsewhere on the board
/FPGA/R4: U6.4 (A2); also elsewhere on the board
/FPGA/STRIP1: U4.8 (A6); also elsewhere on the board
/FPGA/STRIP2: U4.9 (A7); also elsewhere on the board
/FPGA/STRIP3: U6.2 (A0); also elsewhere on the board
/FPGA/STRIP4: U6.3 (A1); also elsewhere on the board
/Level Shifters/A_RCLK_out: J2.9, J3.9, U5.18 (B0)
/Level Shifters/B1_out: J2.1, U4.16 (B2)
/Level Shifters/B2_out: J2.5, U4.15 (B3)
/Level Shifters/B3_out: J3.1, U6.12 (B6)
/Level Shifters/B4_out: J3.5, U6.15 (B3)
/Level Shifters/BLNK_out: J2.15, J3.15, U5.12 (B6)
/Level Shifters/B_out: J2.10, J3.10, U5.17 (B1)
/Level Shifters/CLK_out: J2.13, J3.13, U5.14 (B4)
/Level Shifters/C_RDAT_out: J2.11, J3.11, U5.16 (B2)
/Level Shifters/D_out: J2.12, J3.12, U5.15 (B3)
/Level Shifters/G1_out: J2.2, U4.17 (B1)
/Level Shifters/G2_out: J2.6, U4.14 (B4)
/Level Shifters/G3_out: J3.2, U6.13 (B5)
/Level Shifters/G4_out: J3.6, U6.14 (B4)
/Level Shifters/LAT_out: J2.14, J3.14, U5.13 (B5)
/Level Shifters/LED1_out: J6.2, U4.12 (B6)
/Level Shifters/LED2_out: J7.2, U4.11 (B7)
/Level Shifters/LED3_out: J8.2, U6.18 (B0)
/Level Shifters/LED4_out: J9.2, U6.17 (B1)
/Level Shifters/R1_out: J2.3, U4.18 (B0)
/Level Shifters/R2_out: J2.7, U4.13 (B5)
/Level Shifters/R3_out: J3.3, U6.11 (B7)
/Level Shifters/R4_out: J3.7, U6.16 (B2)
GND: C24.1, C25.1, C26.1, J2.4, J2.8, J2.16, J3.4, J3.8, J3.16, J5.1, J6.3, J7.3, J8.3, J9.3, U4.10 (GND), U4.19 (CE), U5.9 (A7), U5.10 (GND), U5.19 (CE), U6.10 (GND), U6.19 (CE); also elsewhere on the board

Notes on the sheet:
LED1
Matrix GND
LED2
LED3
LED4
Matrix 5V
Output Connectors
Shifters

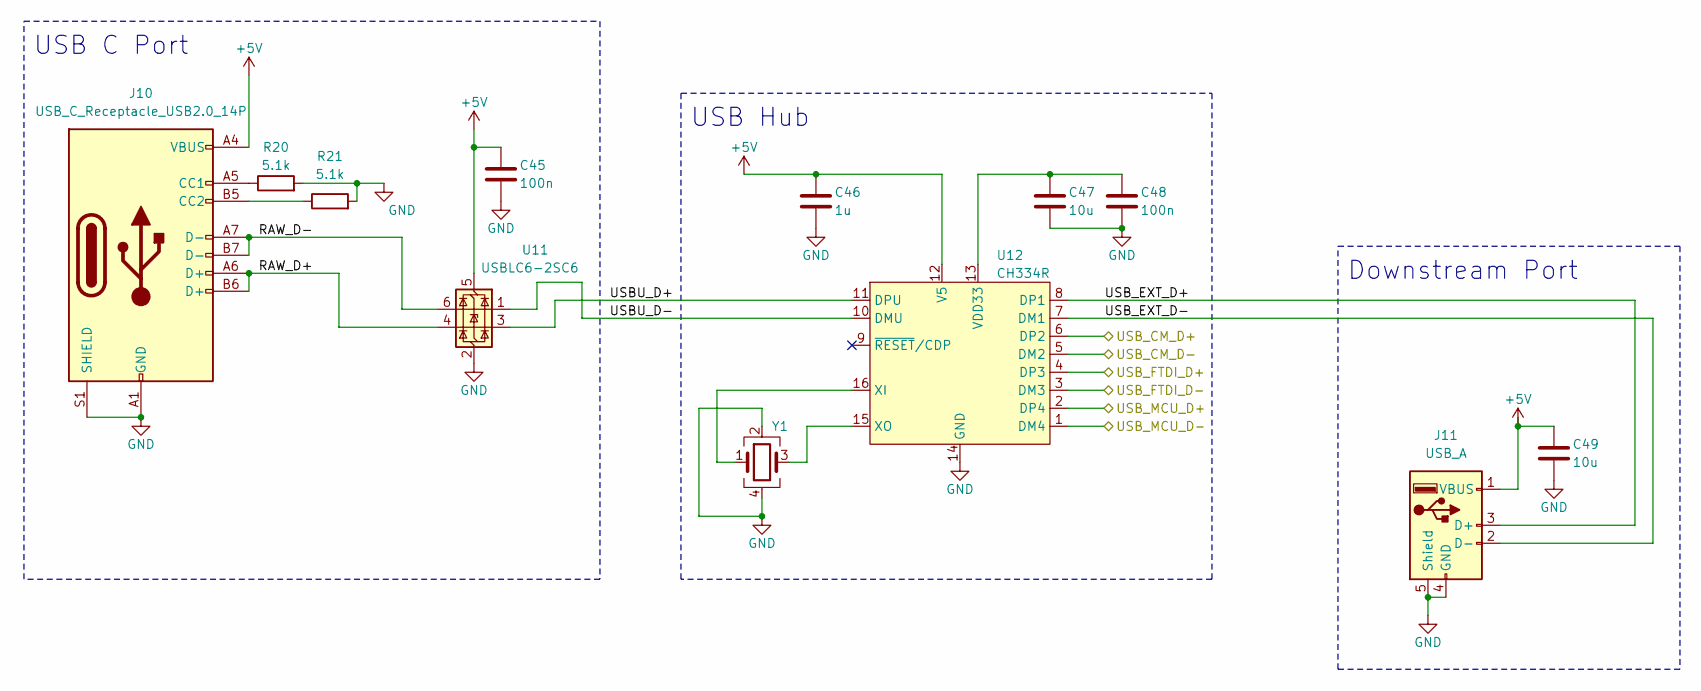
[picture p17: schematic USBHub.kicad_sch]

Parts:
C45, C48: 100n; C_0603_1608Metric
C46: 1u; C_0603_1608Metric
C47, C49: 10u; C_0603_1608Metric
J10: USB_C_Receptacle_USB2.0_14P; GCT_USB4145-03-0170-C_REVA2
J11: USB_A; SS-52100-002
R20, R21: 5.1k; R_0603_1608Metric
U11: USBLC6-2SC6; SOT-23-6
U12: CH334R; SSOP-16_3.9x4.9mm_P0.635mm; LCSC Part C4154405
Y1: Crystal_GND24; Crystal_SMD_3225-4Pin_3.2x2.5mm

Connections:
+5V: C45.1, C46.1, C49.1, J10.A4 (VBUS), J10.A9 (VBUS), J10.B4 (VBUS), J10.B9 (VBUS), J11.1 (VBUS), U11.5 (VBUS), U12.12 (V5); also elsewhere on the board
/FTDI/USB_D+: U12.4 (DP3); also elsewhere on the board
/FTDI/USB_D-: U12.3 (DM3); also elsewhere on the board
/MCU/USB_D+: U12.2 (DP4); also elsewhere on the board
/MCU/USB_D-: U12.1 (DM4); also elsewhere on the board
/USB Audio/USB_D+: U12.6 (DP2); also elsewhere on the board
/USB Audio/USB_D-: U12.5 (DM2); also elsewhere on the board
/USB Hub/RAW_D+: J10.A6 (D+), J10.B6 (D+), U11.4 (I/O2)
/USB Hub/RAW_D-: J10.A7 (D-), J10.B7 (D-), U11.6 (I/O1)
/USB Hub/USBU_D+: U11.3 (I/O2), U12.11 (DPU)
/USB Hub/USBU_D-: U11.1 (I/O1), U12.10 (DMU)
/USB Hub/USB_EXT_D+: J11.3 (D+), U12.8 (DP1)
/USB Hub/USB_EXT_D-: J11.2 (D-), U12.7 (DM1)
GND: C45.2, C46.2, C47.2, C48.2, C49.2, J10.A1 (GND), J10.A12 (GND), J10.B1 (GND), J10.B12 (GND), J10.S1 (SHIELD), J11.4 (GND), J11.5 (Shield), R20.2, R21.2, U11.2 (GND), U12.14 (GND), Y1.2, Y1.4; also elsewhere on the board
unnamed: J10.A5 (CC1), R20.1
unnamed: J10.B5 (CC2), R21.1
unnamed: C47.1, C48.1, U12.13 (VDD33)
unnamed: U12.16 (XI), Y1.1
unnamed: U12.15 (XO), Y1.3

Notes on the sheet:
USB Hub
USB C Port
Downstream Port

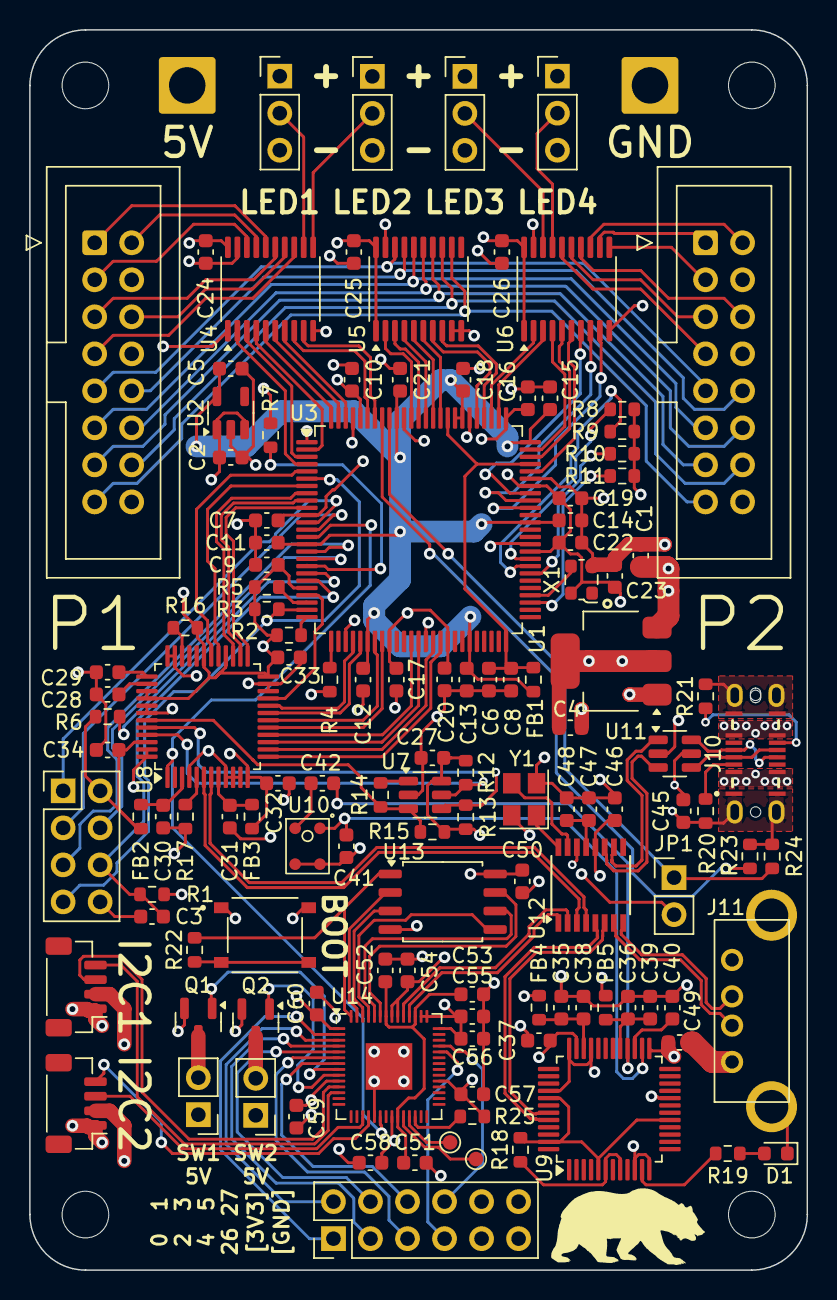
[picture p18: board HUB75-FPGA-Card.kicad_pcb from above]

Board: 4 copper layers, 53.3 x 85.1 mm, 131 parts (0 on the bottom side), 148 nets.
