will-hut/Prototypical/HW/USBC-Injector/USBC-Injector.kicad_pcb

## KiCad design HW/USBC-Injector/USBC-Injector.kicad_pcb (2024-02-26)

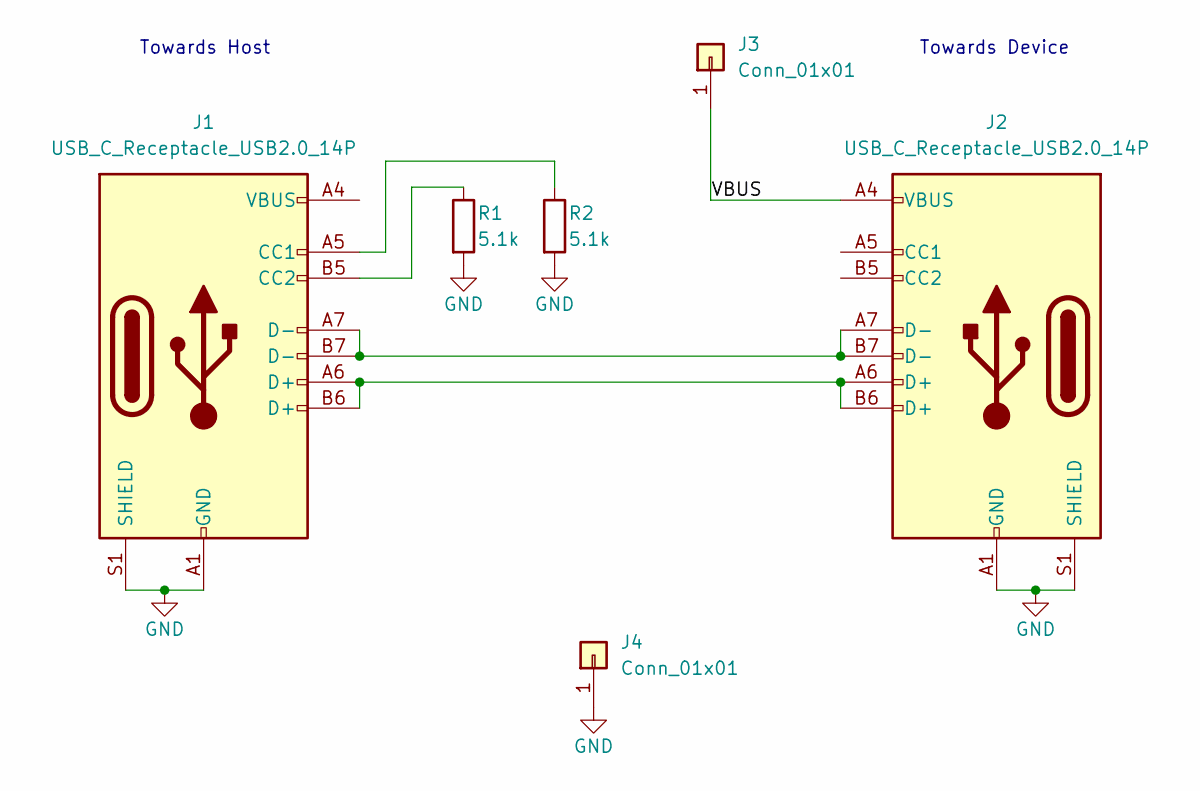
[picture p19: schematic USBC-Injector.kicad_sch]

Parts:
J1, J2: USB_C_Receptacle_USB2.0_14P; USB_C_Receptacle_GCT_USB4105-xx-A_16P_TopMnt_Horizontal
J3, J4: Conn_01x01; TestPoint_Keystone_5019_Minature
R1, R2: 5.1k; R_0603_1608Metric

Connections:
/VBUS: J2.A4 (VBUS), J2.A9 (VBUS), J2.B4 (VBUS), J2.B9 (VBUS), J3.1
GND: J1.A1 (GND), J1.A12 (GND), J1.B1 (GND), J1.B12 (GND), J1.S1 (SHIELD), J2.A1 (GND), J2.A12 (GND), J2.B1 (GND), J2.B12 (GND), J2.S1 (SHIELD), J4.1, R1.2, R2.2
unnamed: J1.A5 (CC1), R2.1
unnamed: J1.B5 (CC2), R1.1
unnamed: J1.A6 (D+), J1.B6 (D+), J2.A6 (D+), J2.B6 (D+)
unnamed: J1.A7 (D-), J1.B7 (D-), J2.A7 (D-), J2.B7 (D-)
unnamed: J1.A4 (VBUS), J1.A9 (VBUS), J1.B4 (VBUS), J1.B9 (VBUS)

Notes on the sheet:
Towards Host
Towards Device

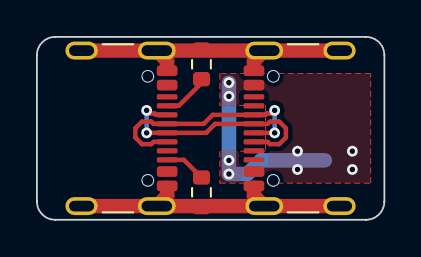
[picture p20: board USBC-Injector.kicad_pcb from above]

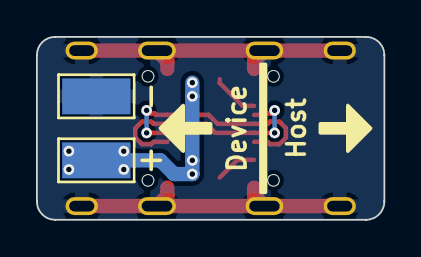
[picture p21: board USBC-Injector.kicad_pcb from below]

Board: 2 copper layers, 19.3 x 10.2 mm, 6 parts (2 on the bottom side), 7 nets.
