will-hut/Prototypical/HDL/Verilog/gamma_correction.v

`timescale 10ns/100ps

module gamma_correction(
	input [6:0] red_in,
	input [6:0] green_in,
	input [5:0] blue_in,
	output reg [7:0] red_out,
	output reg [7:0] green_out,
	output reg [7:0] blue_out
);

always @(red_in) begin
	case (red_in)
		7'd0:	red_out = 8'd0;
		7'd1:	red_out = 8'd0;
		7'd2:	red_out = 8'd0;
		7'd3:	red_out = 8'd0;
		7'd4:	red_out = 8'd0;
		7'd5:	red_out = 8'd0;
		7'd6:	red_out = 8'd0;
		7'd7:	red_out = 8'd0;
		7'd8:	red_out = 8'd0;
		7'd9:	red_out = 8'd0;
		7'd10:	red_out = 8'd0;
		7'd11:	red_out = 8'd0;
		7'd12:	red_out = 8'd0;
		7'd13:	red_out = 8'd0;
		7'd14:	red_out = 8'd1;
		7'd15:	red_out = 8'd1;
		7'd16:	red_out = 8'd1;
		7'd17:	red_out = 8'd1;
		7'd18:	red_out = 8'd1;
		7'd19:	red_out = 8'd1;
		7'd20:	red_out = 8'd1;
		7'd21:	red_out = 8'd2;
		7'd22:	red_out = 8'd2;
		7'd23:	red_out = 8'd2;
		7'd24:	red_out = 8'd2;
		7'd25:	red_out = 8'd3;
		7'd26:	red_out = 8'd3;
		7'd27:	red_out = 8'd3;
		7'd28:	red_out = 8'd4;
		7'd29:	red_out = 8'd4;
		7'd30:	red_out = 8'd4;
		7'd31:	red_out = 8'd5;
		7'd32:	red_out = 8'd5;
		7'd33:	red_out = 8'd6;
		7'd34:	red_out = 8'd6;
		7'd35:	red_out = 8'd7;
		7'd36:	red_out = 8'd7;
		7'd37:	red_out = 8'd8;
		7'd38:	red_out = 8'd9;
		7'd39:	red_out = 8'd9;
		7'd40:	red_out = 8'd10;
		7'd41:	red_out = 8'd11;
		7'd42:	red_out = 8'd12;
		7'd43:	red_out = 8'd12;
		7'd44:	red_out = 8'd13;
		7'd45:	red_out = 8'd14;
		7'd46:	red_out = 8'd15;
		7'd47:	red_out = 8'd16;
		7'd48:	red_out = 8'd17;
		7'd49:	red_out = 8'd18;
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
		6'd52:	blue_out = 8'd149;
		6'd53:	blue_out = 8'd157;
		6'd54:	blue_out = 8'd166;
		6'd55:	blue_out = 8'd174;
		6'd56:	blue_out = 8'd183;
		6'd57:	blue_out = 8'd193;
		6'd58:	blue_out = 8'd202;
		6'd59:	blue_out = 8'd212;
		6'd60:	blue_out = 8'd222;
		6'd61:	blue_out = 8'd233;
		6'd62:	blue_out = 8'd244;
		6'd63:	blue_out = 8'd255;
	endcase
end

endmodule
