will-hut/Prototypical/(commit log)

2023-12-11 fix row select logic and implement lower brightness
    row select data bit may still be off by one
    [hub75_fetchshift.v, hub75_mainfsm.v, hub75_top.v]
2023-12-11 fix row select, first successful test on FPGA
    yay
    [hub75_fetchshift.v, hub75_mainfsm.v, hub75_top.v]
2023-12-20 add working read from framebuffer
    i'm so excited this works on the FPGA
2023-12-23 add processing socket sender util
2023-12-23 create unix domain sockets sample program
2023-12-24 fix timing and add frame_start signal
    [hub75_fetchshift.v, hub75_top.v, hub75_top_tb.v]
2023-12-25 slot ftdi module into main design/testbench for further development
2023-12-30 potential implementation of ftdi framebuffer writing and swapping
    [framebuffer.v, ftdi.v, ftdi_top.v, hub75_top.v, hub75_top_tb.v]
2023-12-30 ftdi frame input working successfully
    working proof of concept done yay
2024-01-03 update screen sender program to 64 bit and add systemd service
    Auto stash before revert of "update screen sender program to 64 bit and add systemd service"
    [SocketSender.pde, main.c]
2024-01-05 initial hardware commit
    [FPGA.kicad_sch, FTDI.kicad_sch, HUB75-FPGA-Card.kicad_pcb, HUB75-FPGA-Card.kicad_sch, Hub75.kicad_sch, Power.kicad_sch]
2024-01-05 update .gitignore for kicad
2024-01-05 provision address space for led strips
2024-01-05 add bram blocks for led strips
    compiles on FPGA
2024-01-16 add ws2812 led strip support
    all HDL in place now, yay
2024-01-22 add usb audio implementation
    [FPGA.kicad_sch, FTDI.kicad_sch, HUB75-FPGA-Card.kicad_pcb, HUB75-FPGA-Card.kicad_sch, Hub75.kicad_sch, USBAudio.kicad_sch]
2024-01-22 rename Hub75 schematic page to LevelShifters
    [HUB75-FPGA-Card.kicad_sch, LevelShifters.kicad_sch]
2024-01-23 finish up schematic and begin routing
    [FPGA.kicad_sch, FTDI.kicad_sch, HUB75-FPGA-Card.kicad_pcb, HUB75-FPGA-Card.kicad_sch, LevelShifters.kicad_sch, Power.kicad_sch, USBAudio.kicad_sch, USBHub.kicad_sch]
2024-01-25 finalize pcb and generate production files for first run
    [FPGA.kicad_sch, FTDI.kicad_sch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]
2024-01-25 fix cross compile bug
    [SocketSender.pde, main.c]
2024-01-29 create (non compliant) usb c power injector
    [HUB75-FPGA-Card.xlsx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]
2024-02-01 add efinity projects and fix hdl typo
    [debug_TEMPLATE.v, debug_TEMPLATE.vhd, hub75_top.v, jtag2spi_tmpl.v, jtag2spi_tmpl.vhd, loader.v]
2024-02-01 beginning of board rev 1.1
    [HUB75-FPGA-Card.kicad_pcb, USBAudio.kicad_sch]
2024-02-05 fix minor pcb annoyances
    [HUB75-FPGA-Card.kicad_pcb]
2024-02-08 saving hardware progress
    [FPGA.kicad_sch, HUB75-FPGA-Card.kicad_pcb, HUB75-FPGA-Card.kicad_sch, LevelShifters.kicad_sch, MCU.kicad_sch, USB4145-03-0170-C_REVA2.step, USBAudio.kicad_sch, USBHub.kicad_sch]
2024-02-10 initial v1.1 board layout
    still needs rp2040 pins routed
    [AMM-3742-T-R--3DModel-STEP-461651.STEP, FPGA.kicad_sch, FTDI.kicad_sch, HUB75-FPGA-Card.kicad_pcb, HUB75-FPGA-Card.kicad_sch, LevelShifters.kicad_sch, MCU.kicad_sch, SS-52100-002--3DModel-STEP-510211.STEP]
2024-02-11 finish rp2040 routing
    [HUB75-FPGA-Card.kicad_pcb, MCU.kicad_sch]
2024-02-12 update components and generate production files
    still need to look into CBSEL
    [FPGA.kicad_sch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]
2024-02-21 initial design for sbc 5v power board
    [Buck.kicad_sch, FPGA.kicad_sch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]
2024-02-24 final v1.1 commit
    boards ordered
    [HUB75-FPGA-Card-CuBottom.gbr, HUB75-FPGA-Card-CuIn1.gbr, HUB75-FPGA-Card-CuIn2.gbr, HUB75-FPGA-Card-CuTop.gbr, HUB75-FPGA-Card-EdgeCuts.gbr, HUB75-FPGA-Card-MaskBottom.gbr, HUB75-FPGA-Card-MaskTop.gbr, HUB75-FPGA-Card-NPTH.drl]
2024-02-26 migrate to kicad 8
    [Buck.kicad_sch, FPGA.kicad_sch, FTDI.kicad_sch, HUB75-FPGA-Card.kicad_pcb, HUB75-FPGA-Card.kicad_sch, LevelShifters.kicad_sch, MCU.kicad_sch, Power-Module.kicad_pcb]
2024-03-04 update HDL to board v1.1
2024-03-05 update matrix order and add efinity project file xmls
    gitignore excluded xmls
    [BOM-HUB75-FPGA-Card.csv, BOM-Power-Module.csv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]
2024-03-08 Upload main Processing program/demo
    also improved socketsender
2024-03-09 improve main processing program
    add accelerometer reactions
2026-05-05 Add pico firmware and improve processing sketch
